nakujaproject/avionicsN2_JLC_Computer/README.md

# avionicsv2
Contains N2 related avionics; telemetry, payload camera...
