nakujaproject/avionicsN2_JLC_Computer/COMPUTER_PCB/back3Dview.JPG

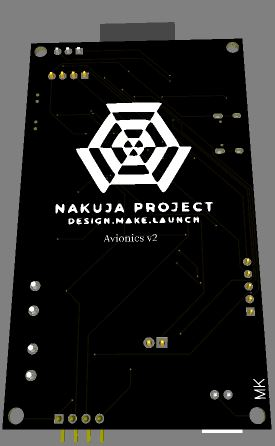
COMPUTER_PCB/back3Dview.JPG
