nakujaproject/avionicsN2_JLC_Computer/COMPUTER_PCB/front3Dview.JPG

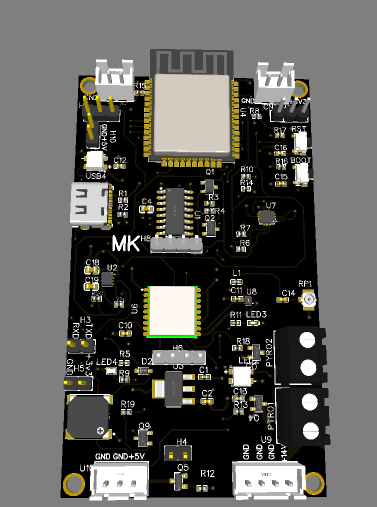
COMPUTER_PCB/front3Dview.JPG
