nakujaproject/avionicsN2_JLC_Computer/COMPUTER_PCB/Schematic_N2 Avionics board.pdf

## ESP

## DELAY

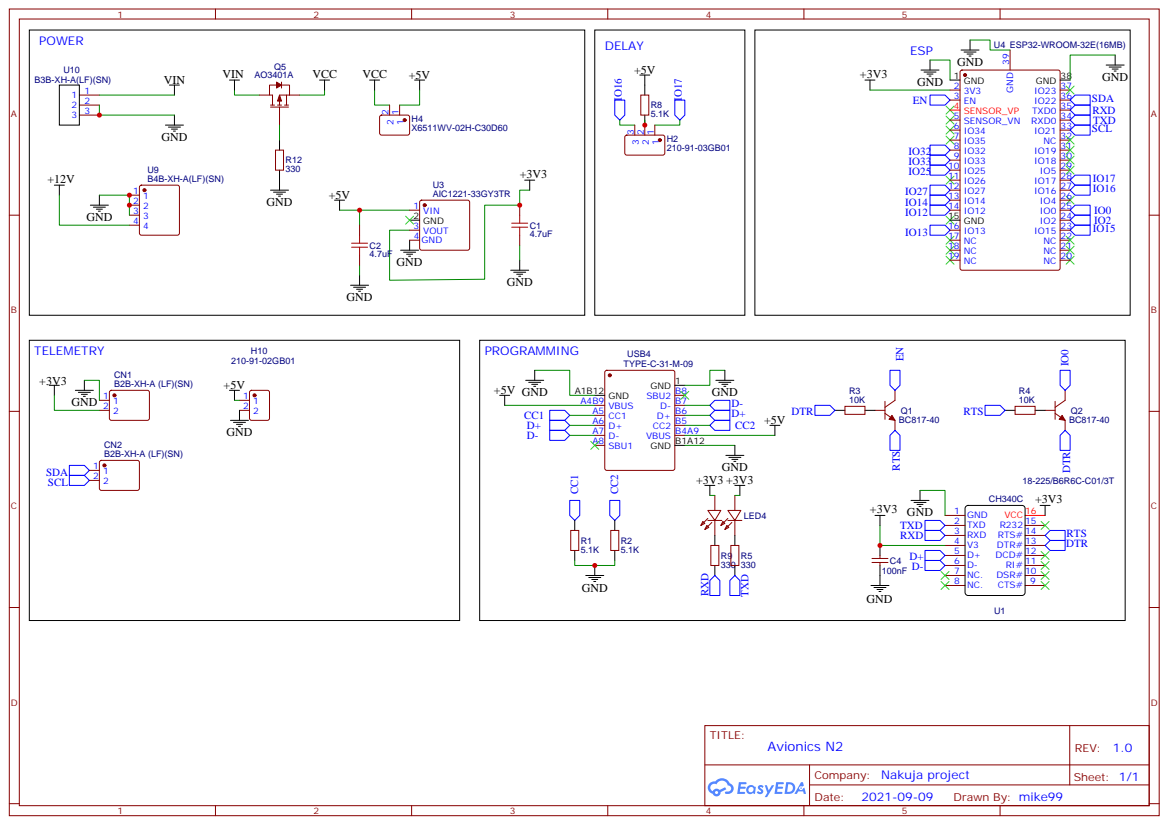
[picture p3: page 1]

## Indicators

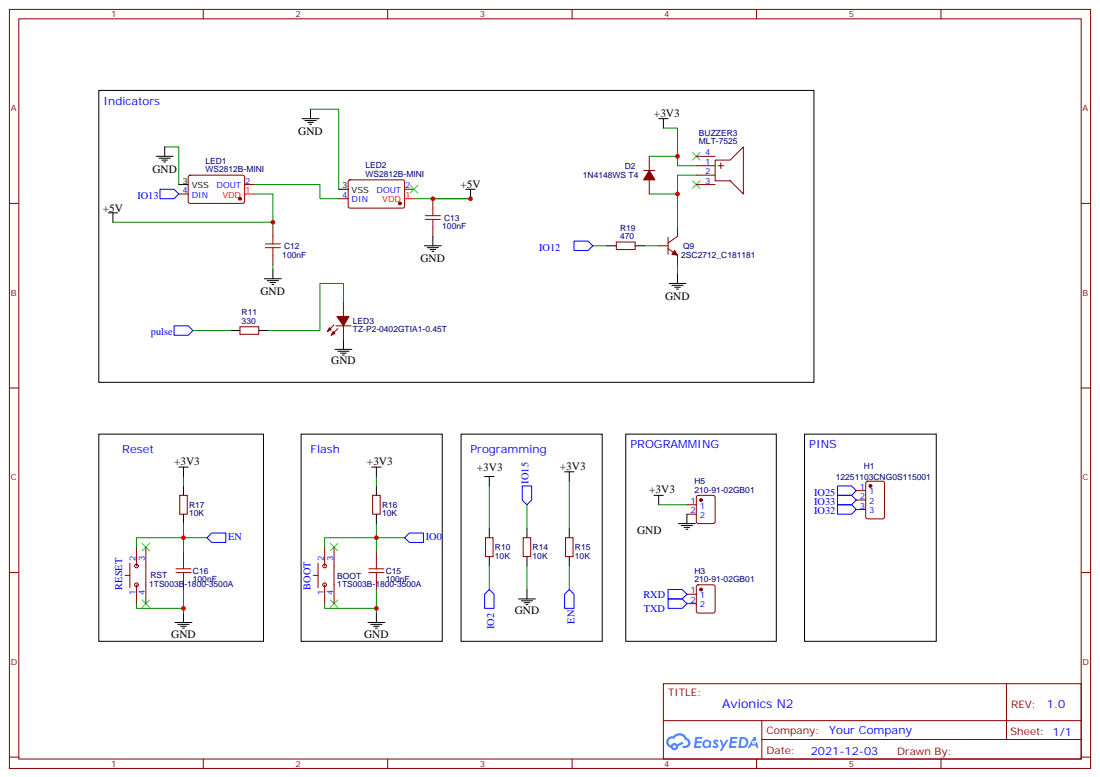
[picture p4: page 2]

## PRESSURE SENSOR

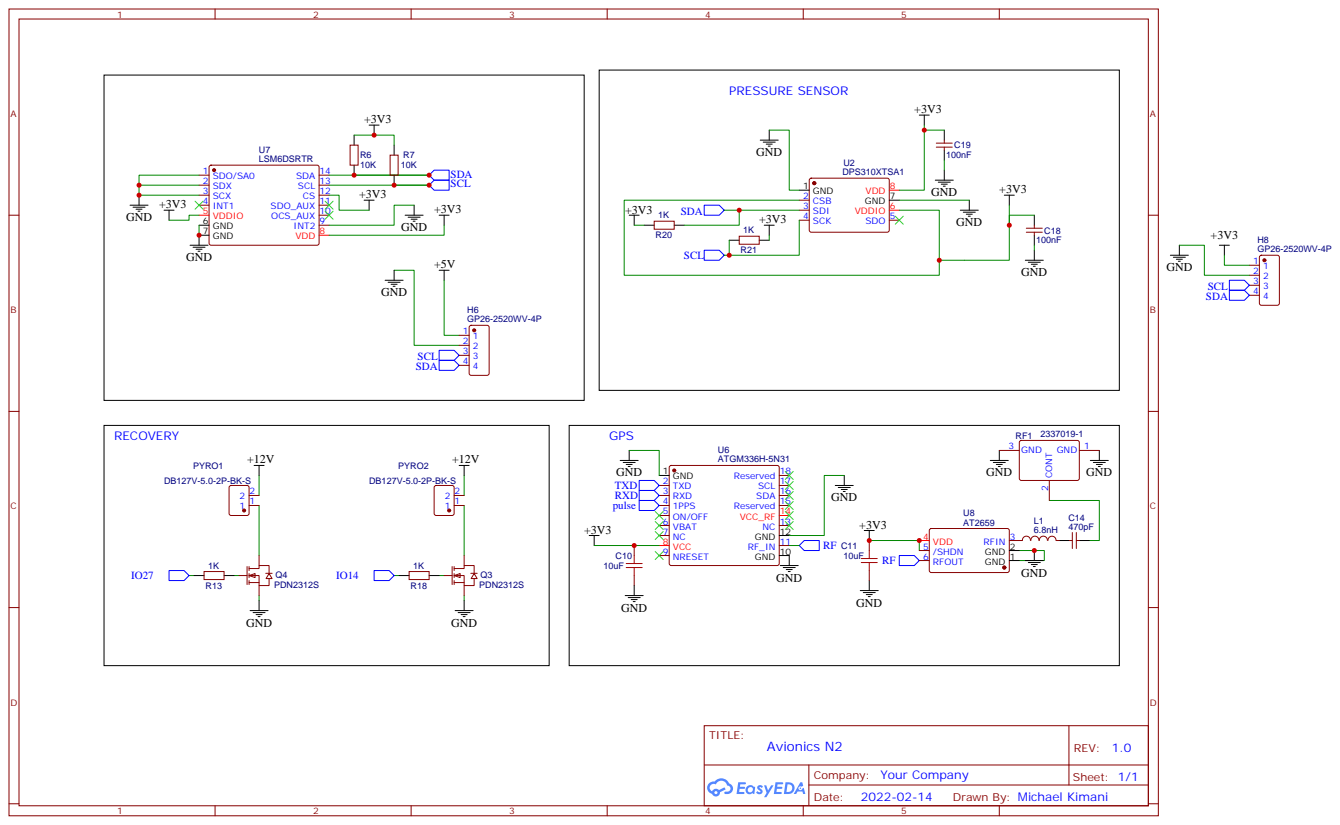
[picture p5: page 3]

Drawn By: Michael Kimani
