nakujaproject/avionicsN2_JLC_Computer/COMPUTER_PCB/PCB_PCB_N2 Avionics board.pdf

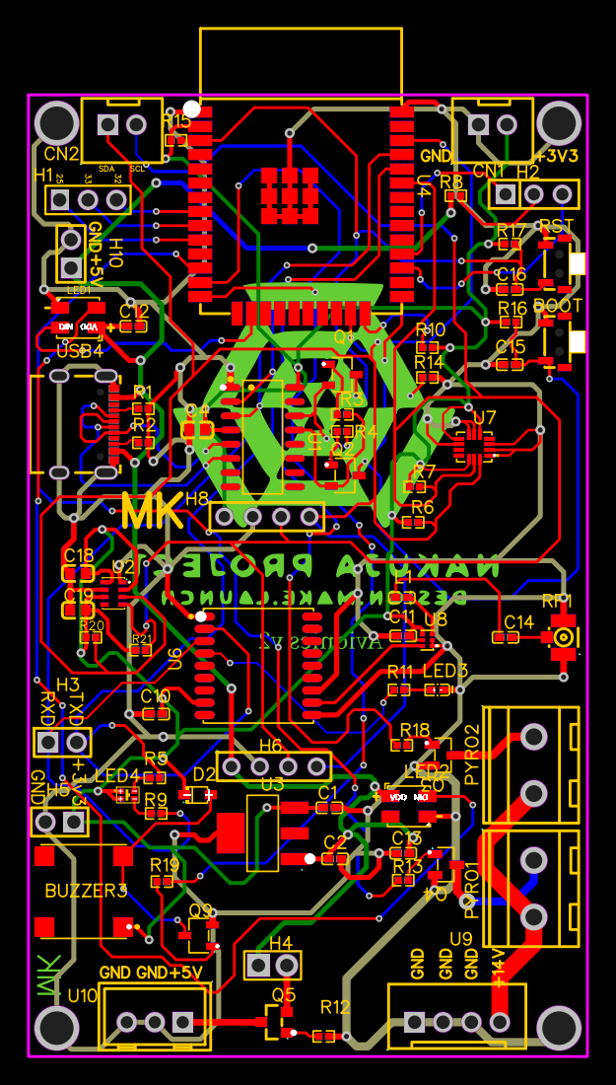
[picture p6: page 1]
