nakujaproject/avionicsN2_JLC_Computer/COMPUTER_PCB/PCB_PCB_N2 Avionics board_2021-12-13.pdf

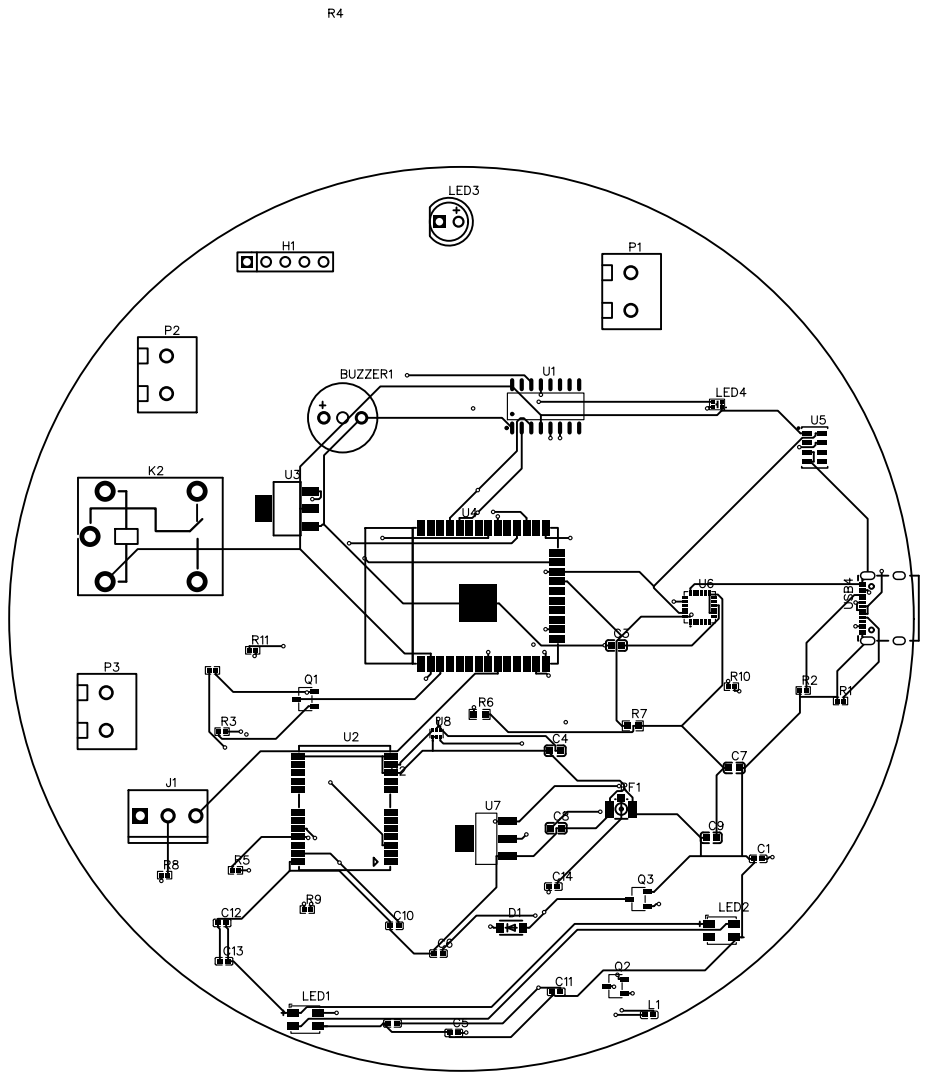
[picture p7: page 1]
