nakujaproject/avionicsN2_JLC_Computer/(list of files, drawings)

Other design files:
COMPUTER_PCB/PCB_N2 Avionics board_2.json
