nakujaproject/avionicsN2_JLC_Computer/(threads)

Thread 1 (2021-06-27):

Telemetry

Mike-Kimani, 2021-06-27:
Using I2C

0x6f736f646f, 2022-01-08:
Done on [this](https://github.com/nakujaproject/N2-onboardTelemetry) repo

SammyOina, 2022-01-09:
Consider adding additional I2C lines for future components

SammyOina, 2022-01-09:
@0x6f736f646f there are incomplete nets such as LEDR, MOSI and others

0x6f736f646f, 2022-01-09:
> @0x6f736f646f there are incomplete nets such as LEDR, MOSI and others

For which design?
I was saying the issue shouldn't be on this repo as it doesn't have a telemetry PCB. I agree with you @Mike-Kimani should provide i2c lines for telemetry

SammyOina, 2022-01-09:
> > @0x6f736f646f there are incomplete nets such as LEDR, MOSI and others
>
> For which design? I was saying the issue shouldn't be on this repo as it doesn't have a telemetry PCB. I agree with you @Mike-Kimani should provide i2c lines for telemetry

For the telemetry PCB, I can create an issue in that repo instead

0x6f736f646f, 2022-01-09:
Okay

Mike-Kimani, 2022-03-08:
I2C lines for telemetry provided.

Closed 2022-03-08.

Thread 6 (2021-09-16):

GPS

Mike-Kimani, 2021-09-16:
Search for and choose most appropriate GPS sensor on JLCPCB. Build necessary circuitry to interface the sensor with an esp32.

0x6f736f646f, 2022-01-08:
Updates on this?

Mike-Kimani, 2022-03-01:
> Updates on this?

Yes. It's done.

Closed 2022-03-03.

Thread 10 (2021-12-13):

Review PCB

Mike-Kimani, 2021-12-13:
Review avionics PCB files before order [Here](https://github.com/nakujaproject/avionicsv2/tree/main/COMPUTER_PCB)

0x6f736f646f, 2021-12-13:
@Mike-Kimani Provide I2C communication lines for sending data to the telemetry computer

0x6f736f646f, 2022-01-08:
> @Mike-Kimani Provide I2C communication lines for sending data to the telemetry computer

Feedback on this?

SammyOina, 2022-01-09:
Consider switching buzzer to active buzzer such as mlt-7525

0x6f736f646f, 2022-01-09:
Also nimeona some strange LED's why those?

Mike-Kimani, 2022-01-10:
@0x6f736f646f  I'll provide the I2C lines

Mike-Kimani, 2022-01-10:
> Also nimeona some strange LED's why those?

Cool factor.

0x6f736f646f, 2022-01-10:
> > Also nimeona some strange LED's why those?
>
> Cool factor.

What is a cool factor?
Are they RGB? ama?

Mike-Kimani, 2022-01-25:
@SammyOina Comment on this.

SammyOina, 2022-02-15:
> @SammyOina Comment on this.

of course, RGB is cool. The ws2812b provides a wide range of indicators that can be used to demonstrate different states. They can also be paired up and addressed using a single data line

Closed 2022-03-02.

Thread 12 (2022-01-08):

Add reverse voltage protection

0x6f736f646f, 2022-01-08:
Add a simple circuit to protect your device against accidental reverse polarity connections. You can design the circuit to operate between 1.5V to 12V DC input circuits.

Ref
1. [Here](https://easyeda.com/i47labs/protection-circuit)

0x6f736f646f, 2022-02-01:
Any update?

Mike-Kimani, 2022-02-11:
Working on it.

Closed 2022-03-02.

Thread 13 (2022-01-08):

Add overvoltage protection

0x6f736f646f, 2022-01-08:
Add over-voltage protection which shuts down the supply, or clamps the output, when the voltage exceeds a preset level.

Mike-Kimani, 2022-01-09:
What exact component do you want us to protect from over-voltage?

0x6f736f646f, 2022-01-09:
All the components.

0x6f736f646f, 2022-01-09:
Specifically on the power input the voltage regulators

Mike-Kimani, 2022-01-10:
We'll use specific battery voltage. There is hence no risk of having an overvoltage.

0x6f736f646f, 2022-01-10:
> We'll use specific battery voltage. There is hence no risk of having an overvoltage.

😂That is deciding to ignore the eminent threat.
What if some plugs in a different battery with a different voltage?

Mike-Kimani, 2022-01-10:
The Voltage regulator used allows for twice the amount of voltage that is on the schematic. I don't think we will have a problem with overvoltage.

0x6f736f646f, 2022-01-10:
Okay

Mike-Kimani, 2022-01-10:
Alright.

Closed 2022-01-10.

Thread 16 (2022-01-08):

Decoupling capacitors

0x6f736f646f, 2022-01-08:
Place the decoupling capacitors as close as possible to an integrated circuit (IC) on a PCB layout.
Example c5 and c6 should be as close to the vin and vout respectively on u7

Ref
1. [Here](https://i.stack.imgur.com/ENvPJ.png)

Mike-Kimani, 2022-01-09:
I'm redesigning the circuit to move to a rectangular board. I'll do this then.

0x6f736f646f, 2022-01-09:
No problem. Why rectangular though?

Mike-Kimani, 2022-01-10:
Allows for more area as the height is adjustable.

0x6f736f646f, 2022-01-10:
> Allows for more area as the height is adjustable.

Do you have an image of how they will be stacked?

Mike-Kimani, 2022-01-10:
An avionics bay back to back for Avionics and flight control. The telemetry one could be circular and stacked above the two.

0x6f736f646f, 2022-02-16:
Decoupling capacitors should be placed near the +ve line, c12 and c13 should be near leds

Mike-Kimani, 2022-02-20:
They are.

Closed 2022-03-02.

Thread 17 (2022-01-10):

Change Recovery Relays to MOSFETs.

Mike-Kimani, 2022-01-10:
Due to acceleration and vibration of the rocket.

Mike-Kimani, 2022-01-10:
Done.

Closed 2022-01-10.

Thread 19 (2022-02-01):

PCB antenna

0x6f736f646f, 2022-02-01:
# Issue

move the antenna out of the PCB surface

# Demo

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

# Ref
1. Comment on [LinkedIn](https://www.linkedin.com/feed/update/urn:li:activity:6860134286629068800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)

Closed 2022-03-02.

Thread 20 (2022-02-01):

Naming switches

0x6f736f646f, 2022-02-01:
Follow the conversation over at [FC](https://github.com/nakujaproject/flight-control-computer/issues/13#issue-1120365114)

0x6f736f646f, 2022-02-16:
Name them in the schematic too

Closed 2022-03-02.

Thread 21 (2022-02-01):

Mounting holes

0x6f736f646f, 2022-02-01:
Follow the conversation of [here](https://github.com/nakujaproject/flight-control-computer/issues/8#issue-1108458073)

0x6f736f646f, 2022-02-16:
How are your width and height smaller than the hole diameter?

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

Closed 2022-03-02.

Thread 23 (2022-02-01):

GND and VCC positioning

0x6f736f646f, 2022-02-01:
Follow the conversation [here](https://github.com/nakujaproject/flight-control-computer/issues/11)

Closed 2022-03-02.

Thread 25 (2022-02-01):

Connectors

0x6f736f646f, 2022-02-01:
Why are we using this connector, can't we use standard connectors?

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

Mike-Kimani, 2022-02-10:
It faces downwards allowing for easier connection of wires to the telemetry PCB. Could you expound on what you mean by a standard connector?

0x6f736f646f, 2022-02-10:
Can't we just just the normal male header pins then we can have them either straight or right angled

Mike-Kimani, 2022-02-13:
We can have them angled. Either male or female.

0x6f736f646f, 2022-02-16:
Why is H4 at the middle?

0x6f736f646f, 2022-02-16:
What is H2 for?

0x6f736f646f, 2022-02-16:
Add 12v connectors for the camera

0x6f736f646f, 2022-02-16:
Add 5v and 3.3v connector for telemetry

Mike-Kimani, 2022-02-20:
> Why is H4 at the middle?

H4 is just a jumper to complete battery power to the board. It's position doesn't really matter.

Mike-Kimani, 2022-02-20:
> What is H2 for?

It's a feature that allows for delay when setting up on the rocket.

Mike-Kimani, 2022-02-20:
> Add 5v and 3.3v connector for telemetry

+3.3V already added. You need 5V too? What for?

0x6f736f646f, 2022-02-20:
> > Add 5v and 3.3v connector for telemetry
>
> +3.3V already added. You need 5V too? What for?

For WS2812

0x6f736f646f, 2022-02-20:
> > What is H2 for?
>
> It's a feature that allows for delay when setting up on the rocket.

Why can't this delay be done in the software as we would have more than 1 minute between arming the avionics and firing ignition

0x6f736f646f, 2022-02-20:
> > Why is H4 at the middle?
>
> H4 is just a jumper to complete battery power to the board as explained in the other issue. It's position doesn't really matter.

Then why is it at the centre and not at the periphery?

Mike-Kimani, 2022-02-23:
Power goes from the screw terminal to the jumper and then to the rest of the circuit. Do you have a technical reason for having it at the periphery? If so, kindly post it here.

Mike-Kimani, 2022-02-25:
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

I still want us to have a testing mode that does not have the delay. This will be done using both software and hardware.

0x6f736f646f, 2022-03-01:
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

Okay

Closed 2022-03-02.

Thread 29 (2022-02-16):

VCC connection

rodneyosodo, 2022-02-16:
Is that VCC connected to negative?

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

Mike-Kimani, 2022-02-16:
Deja vu😂

No. This is a jumper that only allows powering the board using the battery when the jumper is connected.

Mike-Kimani, 2022-02-17:
I don't mean a jumper wire. I mean using the strapping technique. Check [here](https://en.wikipedia.org/wiki/Jumper_(computing))

0x6f736f646f, 2022-02-17:
> Deja vujoy
>
> No. This is a jumper that only allows powering the board using the battery when the jumper is connected.

You said jumper here

Mike-Kimani, 2022-02-20:
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

Yes. The strapping technique uses a jumper. Not a jumper wire but a jumper [here](https://en.wikipedia.org/wiki/Jumper_(computing))

Closed 2024-08-03.

Thread 30 (2022-02-16):

Rename VCC

rodneyosodo, 2022-02-16:
Rename VCC to either +5V or +3.3v for easier review

Mike-Kimani, 2022-02-16:
What is 5V? What is 3.3v? Reword the comment to +5V and +3.3v.

0x6f736f646f, 2022-02-16:
> What is 5V? What is 3.3v? Reword the comment to +5V and +3.3v.

Yes

0x6f736f646f, 2022-03-02:
To be done by the documentation

Closed 2024-08-03.

Thread 32 (2022-02-16):

Buzzer

0x6f736f646f, 2022-02-16:
Check the flight control buzzer circuit

Mike-Kimani, 2022-02-19:
> Check the flight control buzzer circuit

It's exactly the same already.

0x6f736f646f, 2022-02-19:
Is it like this?

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

Mike-Kimani, 2022-02-20:
Yes.

Mike-Kimani, 2022-03-01:
#28

Mike-Kimani, 2022-03-01:
[](https://github.com/nakujaproject/avionicsv2/pull/28)

Closed 2022-03-02.

Thread 34 (2022-03-11):

Change Pressure sensor

0x6f736f646f, 2022-03-11:
It seems too expensive at $9 per piece

Mike-Kimani, 2022-03-16:
@0x6f736f646f

For such issues kindly suggest a better alternative from a technical point of view to the one that exists on the board.

jamesmacharia861, 2022-03-16:
found a cheaper pressure sensor that uses an accelerometer to detect motion states
[1811031937_STMicroelectronics-LIS3DHTR_C15134.pdf](https://github.com/nakujaproject/avionicsv2/files/8259251/1811031937_STMicroelectronics-LIS3DHTR_C15134.pdf)

0x6f736f646f, 2022-03-16:
> found a cheaper pressure sensor that uses an accelerometer to detect motion states [1811031937_STMicroelectronics-LIS3DHTR_C15134.pdf](https://github.com/nakujaproject/avionicsv2/files/8259251/1811031937_STMicroelectronics-LIS3DHTR_C15134.pdf)

@jamesmacharia861 what you have refered to is an accelerometer but this issue we can to change the pressure sensors to obtain altitude data

jamesmacharia861, 2022-03-22:
DSP310 aka C130156 going at   3.4840 dollars. Its applied in drones and has a favourable voltage consumption of1.2- 3.6V VDD and a low current requirement
[DSP310.pdf](https://github.com/nakujaproject/avionicsv2/files/8321117/DSP310.pdf)

Closed 2022-05-03.

Thread 35 (2022-03-11):

Change GPS module

0x6f736f646f, 2022-03-11:
It is too costly at $ 6.8597 per piece

Mike-Kimani, 2022-03-16:
@0x6f736f646f

For such issues kindly suggest a better alternative from a technical point of view to the one that exists on the board.

0x6f736f646f, 2022-03-16:
You can have a look at ATGM336H-5N31 aka C90770

Thread 36 (2022-03-11):

What is rated voltage for pulse led?

rodneyosodo, 2022-03-11:

Mike-Kimani, 2022-04-15:
A minimum of 2.8V

0x6f736f646f, 2022-04-15:
Nominal of?

Mike-Kimani, 2022-04-15:
Check out the datasheet. [Here](https://datasheet.lcsc.com/lcsc/2006241134_TUOZHAN-TZ-P2-0402GTIA1-0-45T_C688877.pdf)

0x6f736f646f, 2022-04-15:
This is in Chinese

Mike-Kimani, 2022-04-15:
Translate the specific part you want or find an English one.

Closed 2024-08-03.

Thread 37 (2022-03-11):

Change esp32

0x6f736f646f, 2022-03-11:
Your esp32 isn't recommended for new designs

@WashingtonKK

## Ref
1 [Espressif](https://www.espressif.com/sites/default/files/documentation/esp32-wroom-32d_esp32-wroom-32u_datasheet_en.pdf)

0x6f736f646f, 2022-03-13:
It is also expensive at $4.8

Mike-Kimani, 2022-03-16:
@0x6f736f646f

For such issues kindly suggest a better alternative from a technical point of view to the one that exists on the board.

Closed 2022-05-03.

Thread 40 (2022-03-13):

Capacitor on GPS

0x6f736f646f, 2022-03-13:
The capacitor on the GPS should be in series or parallel?
Because I am assuming you are doing some sort of impedance matching or?

Mike-Kimani, 2022-04-15:
From the datasheet.

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

0x6f736f646f, 2022-04-15:
The capacitor around the antenna

Mike-Kimani, 2022-04-15:
From the datasheet.
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

0x6f736f646f, 2022-04-15:
Is it a matching circuit or a filtering circuit?

Mike-Kimani, 2022-04-19:
Should be matching. Issue also discussed [here.](https://github.com/nakujaproject/avionicsv2/issues/43)

0x6f736f646f, 2022-04-19:
If it is a matching circuit then the cap should be in parallel

Mike-Kimani, 2022-04-20:
The datasheet says otherwise.

Mike-Kimani, 2022-04-20:
@georgebangeboss Thoughts on this?

Mike-Kimani, 2022-04-20:
> Should be matching. Issue also discussed [here.](https://github.com/nakujaproject/avionicsv2/issues/43)

It's not a matching circuit. I was wrong on this. It is a series band pass filter.

georgebangeboss, 2022-04-20:
The capacitor is a DC blocking capacitor
The LNA AT2659 datasheet provides sufficient information about the matching circuits. The datasheet is at [https://github.com/nakujaproject/avionicsv2/tree/reviews2/GPS](url)

Here are photo snippets
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

Closed 2022-05-03.

Thread 41 (2022-04-05):

Change pyro channels MOSFETs.

Mike-Kimani, 2022-04-05:
Change MOSFETs to 15A and above current handling capacity.

Mike-Kimani, 2022-04-15:
Tests carried out showed that max current draw during firing of the pyro channels was 3.7A. MOSFETs with 6.7A max current handling capacity should suffice.

Closed 2022-04-15.

Thread 43 (2022-04-07):

Review GPS Module

georgebangeboss, 2022-04-07:

georgebangeboss, 2022-04-08:
The impedance matching circuits are perfect. What is left is adjusting the  widths of RF tracks to achieve controlled track impedance of 50 Ohms. Is the PCB coplanar or microstrip? What substrate material is being used? FR4? Those are used to calculate the correct track width

The 10 uF Bypass capacitor should be as close as possible to the VCC pin of LNA(AT2659) which seems okay visually

Will the shipped PCB come with the GPS antenna?

Mike-Kimani, 2022-04-09:
The PCB is microstrip.

As for the substrate:
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

As per now we'll fabricate the antenna ourselves.

georgebangeboss, 2022-04-11:
L1_1 and RF nets should be 0.29337mm trace width to achieve 50 Ohm controlled impedance

11.55 mil is equivalent to 0.29337mm

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

Closed 2022-05-03.
