nakujaproject/avionicsN2_JLC_Computer/(commit log)

2021-10-22 N2 PCB Schematic
2021-12-13 PCB for review
    [PCB_N2 Avionics board.json]
2021-12-19 Header pins for delay
    [PCB_N2 Avionics board.json]
2022-01-10 Adding 3v rail and I2C lines
2022-01-10 Changing recovery relays to MOSFETs
2022-01-11 Separate USB from main power
2022-01-11 PCB 3D view
2022-01-11 Chaning to a rectangular PCB
    [PCB_N2 Avionics board.json, PCB_N2 Avionics board_2.json]
2022-02-03 I2C BMP channel debug
2022-02-10 Changing to smaller MOSFETs
    [PCB_N2 Avionics board_2.json]
2022-02-15 PCB review issues
    [PCB_N2 Avionics board_2.json]
2022-02-27 More reviews
    [PCB_N2 Avionics board_2.json]
2022-03-16 Routed GND, SDA and SCL
    [PCB_N2 Avionics board_2.json]
2022-04-05 Routing finished
    [PCB_N2 Avionics board_2.json]
2022-04-15 Fixing more issues
    [PCB_N2 Avionics board_2.json]
